muhammedozkan/CSE495-Graduation-Project-I---Flower-Watering-Bot/README.md

# CSE495-Graduation-Project-I-Flower-Watering-Bot

https://www.youtube.com/watch?v=L24rfd-ROjs
