muhammedozkan/CSE495-Graduation-Project-I---Flower-Watering-Bot/Lisans_Bitirme_Projesi_2_sunum.pdf

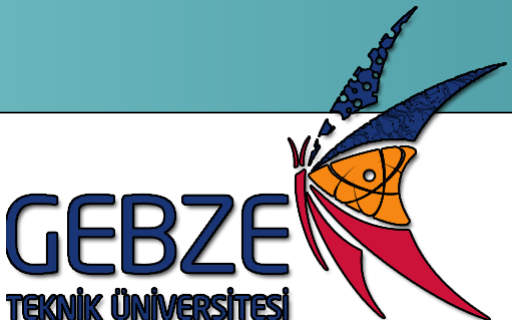
[picture p27: figure]

Bilgisayar Mühendisliği Bölümü

## CSE 495 2.Presentation

## Muhammed ÖZKAN

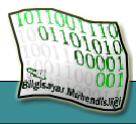
[picture p28: figure]

## Advisor: Dr. Alp Arslan BAYRAKÇI

## 2021 November

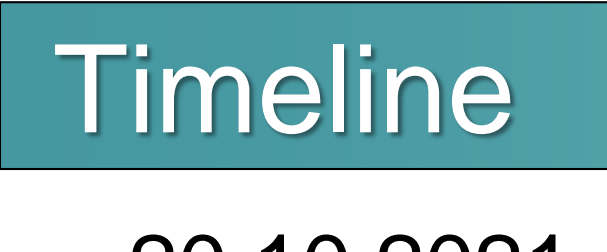
[picture p29: figure]
Timeline

GTÜ - Bilgisayar Mühendisliği Bölümü | BİL 495/496 Bitirme Projesi

# - 20.10.2021 - 10.11.2021 2.Presentation

Combining equipment.
Starting the hardware is the first tests. Performing the operation of finding a flower.

2

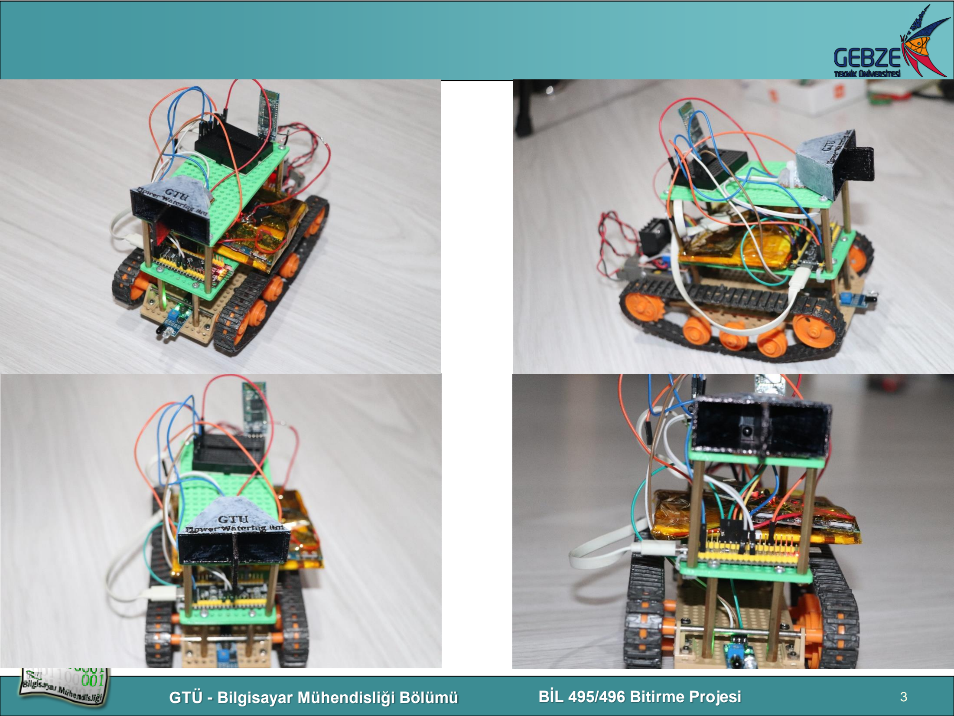
[picture p30: page 3]

GTÜ - Bilgisayar Mühendisliği Bölümü | BİL 495/496 Bitirme Projesi | 3

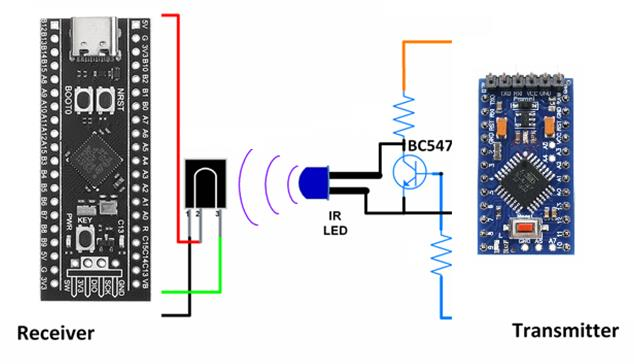
[picture p31: figure]

GTÜ - Bilgisayar Mühendisliği Bölümü | BİL 495/496 Bitirme Projesi | 4

# Scheme and Description of the Project

## - In this project, a

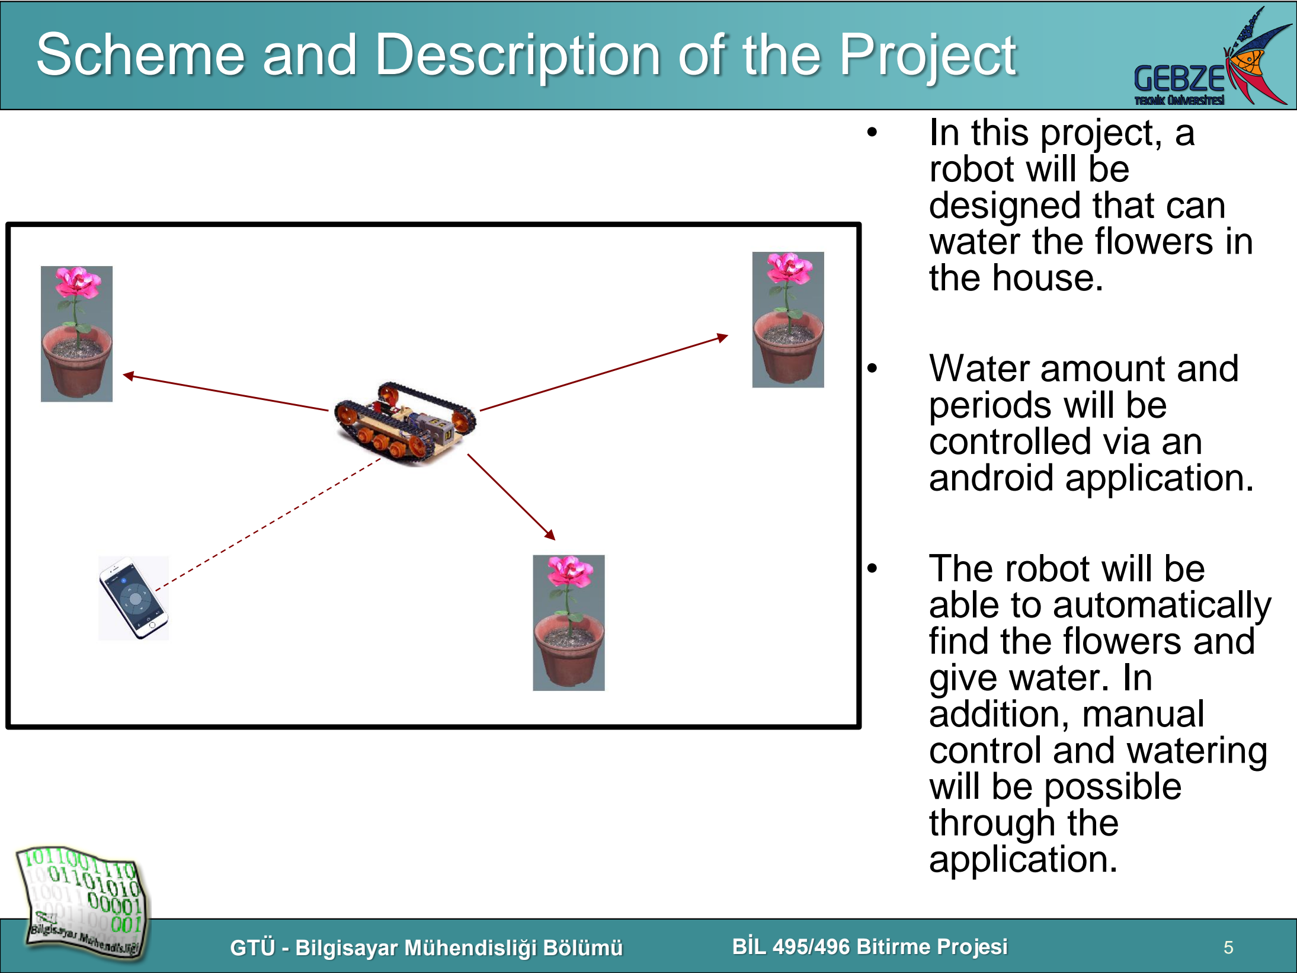
[picture p32: page 5]

GTÜ - Bilgisayar Mühendisliği Bölümü | BİL 495/496 Bitirme Projesi | 5

## robot will be designed that can water the flowers in

the house.

## - Water amount and periods will be controlled via an

android application.

## - The robot will be able to automatically find the flowers and give water. In addition, manual control and watering will be possible through the

application.

# Project Design Plan

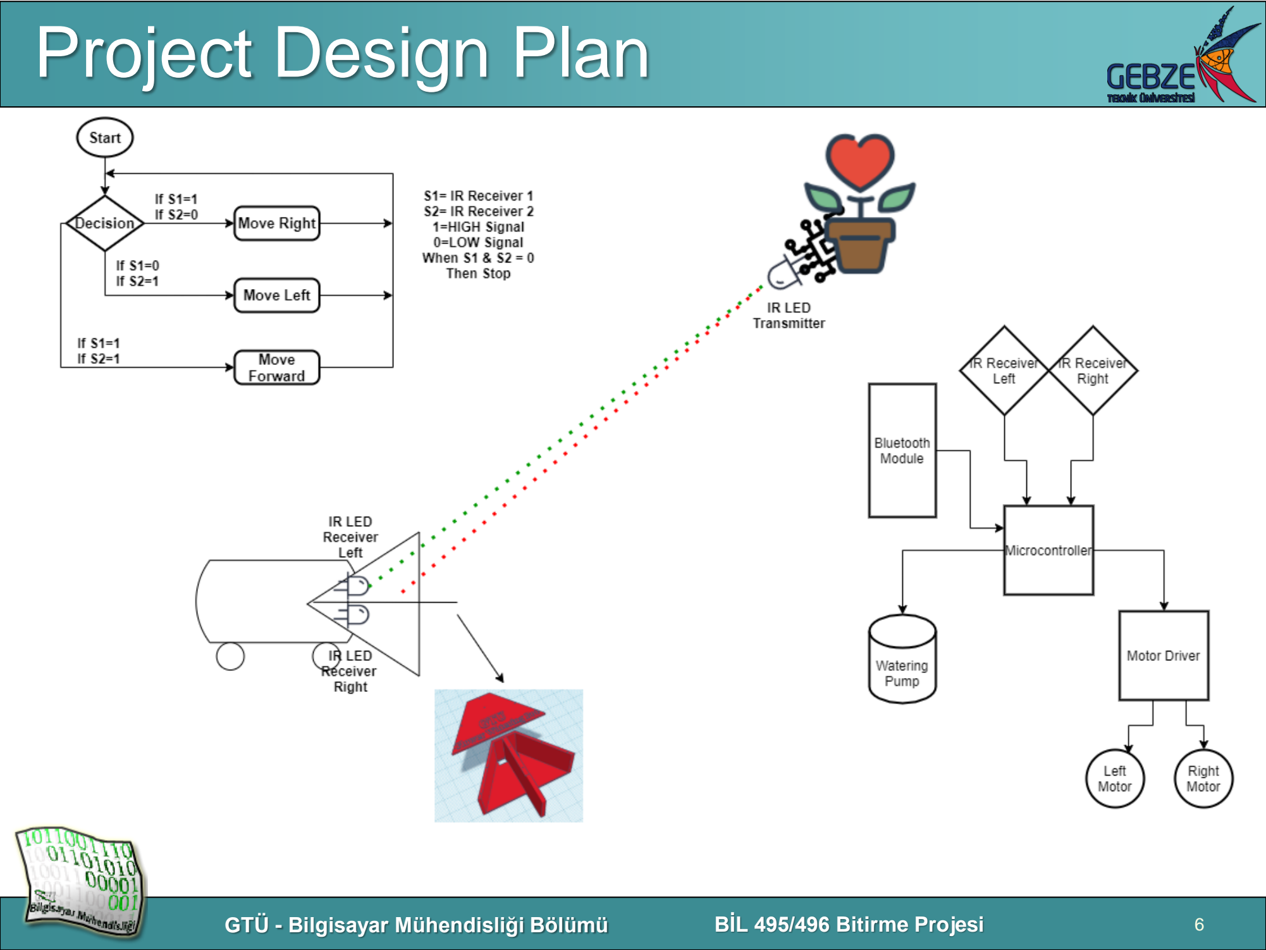
[picture p33: page 6]

GTÜ - Bilgisayar Mühendisliği Bölümü | BİL 495/496 Bitirme Projesi | 6

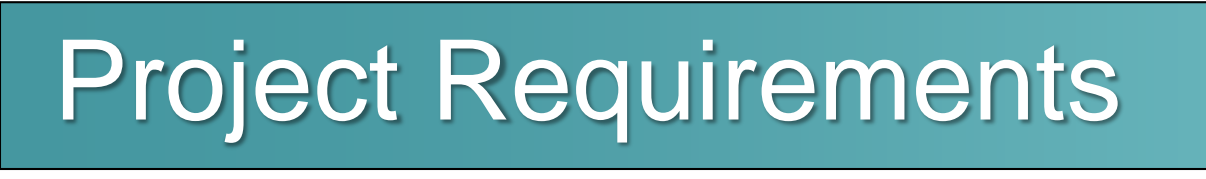
[picture p34: figure]
Project Requirements

GTÜ - Bilgisayar Mühendisliği Bölümü | BİL 495/496 Bitirme Projesi | 7
- All parts of the robot must be put together.

# - A system should be developed for flowers to send IR

signals.

# - An algorithm should be developed for the robot to move

forward with the incoming signals.

# - A system should be developed to find the desired flower by

means of IR signals with the robot.

# - An algorithm should be developed for Bluetooth

communication.
- Android application should be developed for robot control.
- A system should be designed for water pump control.

# Project Requirements

# Hardware Requirements

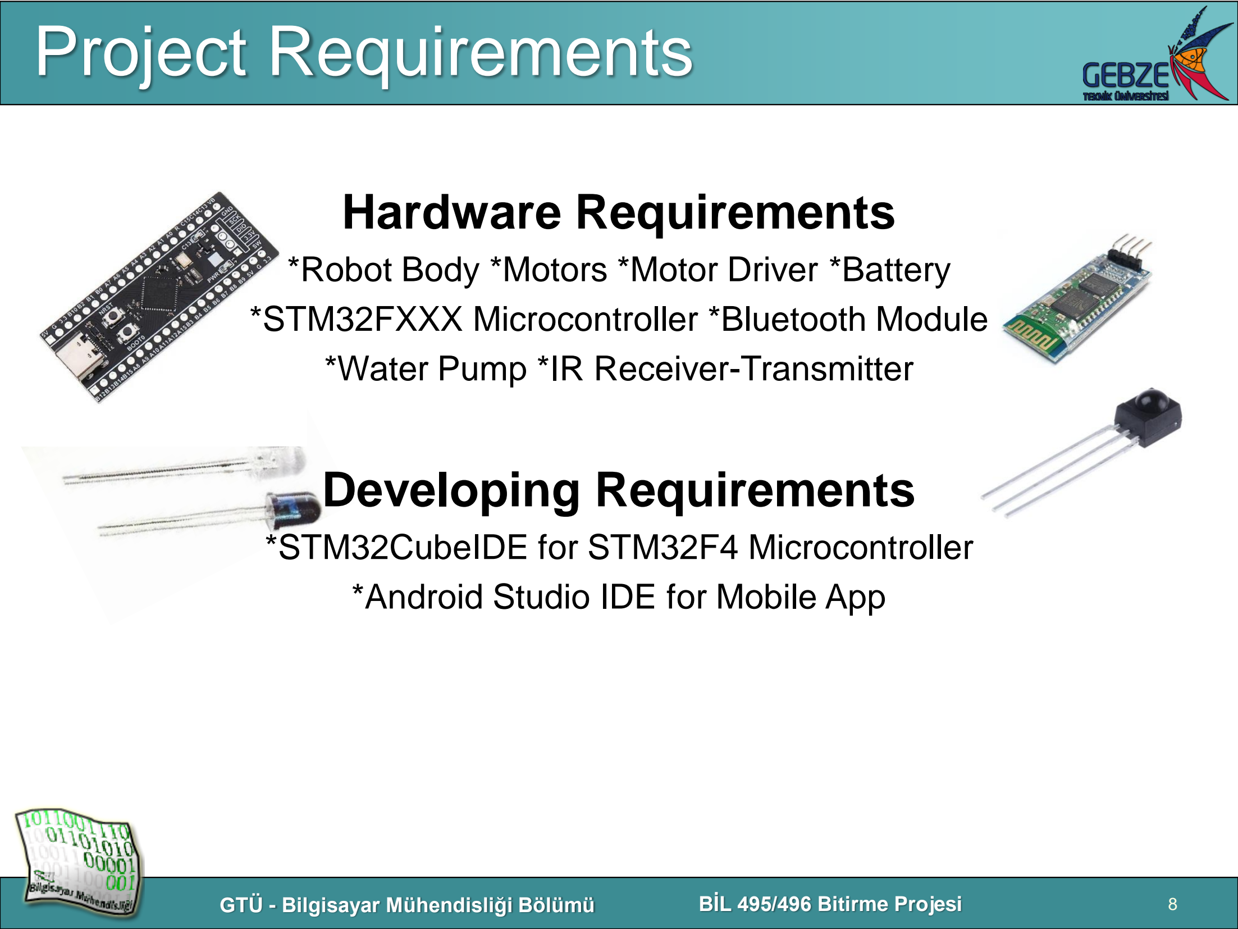
[picture p35: page 8]

GTÜ - Bilgisayar Mühendisliği Bölümü | BİL 495/496 Bitirme Projesi

## *Robot Body *Motors *Motor Driver *Battery *STM32FXXX Microcontroller *Bluetooth Module *Water Pump *IR Receiver-Transmitter

# Developing Requirements

## *STM32CubeIDE for STM32F4 Microcontroller *Android Studio IDE for Mobile App

8

GTÜ - Bilgisayar Mühendisliği Bölümü | BİL 495/496 Bitirme Projesi | 9

# 1. The flower to be watered must be found by the robot

in a 30m² environment.

# 2. The watering period and amount must be adjusted

via Bluetooth by application.

# 3. The flowers must be distinguishable by the device

and be watered differently period and amount.
4. It must be controlled manually via the application.

# (forward, backward, right, left) 5. The pump must be controlled manually via the

application.

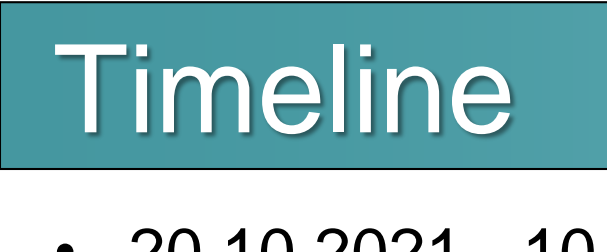
[picture p36: figure]
Timeline

GTÜ - Bilgisayar Mühendisliği Bölümü | BİL 495/496 Bitirme Projesi

# - 20.10.2021 - 10.11.2021 2.Presentation

Combining equipment.
Starting the hardware is the first tests. Performing the operation of finding a flower.

# - 10.11.2021 - 8.12.2021 3.Presentation

The presence of more than one flower separately.
The process of watering the flowers.
Design of mobile application, communication with hardware.

# - 8.12.2021 - 19.01.2022 4.Last Presentation

Control via mobile app.
Watering process via mobile. Watering amount and period setting.

10

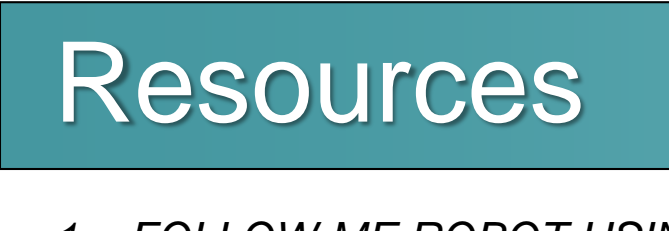
[picture p37: figure]
Resources

GTÜ - Bilgisayar Mühendisliği Bölümü | BİL 495/496 Bitirme Projesi | 11

## 1. FOLLOW ME ROBOT USING INFRARED BEACONS Salman Afghani, Muhammad Ishfaq Javed Army Public College of Management and Sciences, Rawalpindi, PAKISTAN ISSN-L: 2223-9553, ISSN: 2223-9944 Vol. 4 No. 3 May 2013
