muhammedozkan/CSE495-Graduation-Project-I---Flower-Watering-Bot/EmbededCode/WaterFlowerBot/Core/Src/main.c

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
/* Includes ------------------------------------------------------------------*/
#include "main.h"

/* USER CODE BEGIN Includes */
#include "mylib.h"
/* USER CODE END Includes */

TIM_HandleTypeDef htim2;

UART_HandleTypeDef huart1;
UART_HandleTypeDef huart2;
UART_HandleTypeDef huart6;

void SystemClock_Config(void);
static void MX_GPIO_Init(void);
static void MX_USART1_UART_Init(void);
static void MX_USART6_UART_Init(void);
static void MX_USART2_UART_Init(void);
static void MX_TIM2_Init(void);
/* USER CODE BEGIN 0 */
uint8_t Rx_left[10];
uint8_t Rx_right[10];

int8_t left = 0;
int8_t right = 0;

int8_t previous = 0;
uint8_t flowerCode = CODE_R;
uint8_t leftRightForward = 0;



uint16_t findAmount(uint8_t flowerCode)
{
	for (int8_t i = 0; i < 3; i++) {
			if (amount[i].flowerCode == flowerCode)
				return amount[i].waterAmount;
		}
return 0;
}

void stop() {
	HAL_GPIO_WritePin(GPIOA,
			RIGHT_BACKWARD_Pin | LEFT_FORWARD_Pin | LEFT_BACKWARD_Pin
					| RIGHT_FORWARD_Pin, GPIO_PIN_RESET);
	left = 0;
	right = 0;

}

void forward() {
	stop();
	HAL_GPIO_WritePin(GPIOA, RIGHT_FORWARD_Pin | LEFT_FORWARD_Pin,GPIO_PIN_SET);
	left = 1;
	right = 1;
}

void turnLeft() {
	stop();
	HAL_GPIO_WritePin(RIGHT_FORWARD_GPIO_Port, RIGHT_FORWARD_Pin, GPIO_PIN_SET);

	HAL_GPIO_WritePin(LEFT_BACKWARD_GPIO_Port, LEFT_BACKWARD_Pin, GPIO_PIN_SET);
	left = -1;
	right = 1;

	previous = -1;

}

void turnRight() {
	stop();
	HAL_GPIO_WritePin(LEFT_FORWARD_GPIO_Port, LEFT_FORWARD_Pin, GPIO_PIN_SET);

	HAL_GPIO_WritePin(RIGHT_BACKWARD_GPIO_Port, RIGHT_BACKWARD_Pin, GPIO_PIN_SET);
	left = 1;
	right = -1;

	previous = 1;

}
void backward() {
	stop();
	HAL_GPIO_WritePin(GPIOA, RIGHT_BACKWARD_Pin | LEFT_BACKWARD_Pin,GPIO_PIN_SET);
	left = -1;
	right = -1;

}

void readLeftSensor() {
	HAL_UART_Receive(&huart6, Rx_left, 10, 100);
}

void readRightSensor() {
	HAL_UART_Receive(&huart1, Rx_right, 10, 100);
}

void pumpON() {
	HAL_GPIO_WritePin(WATER_PUMP_GPIO_Port, WATER_PUMP_Pin, GPIO_PIN_RESET);
}

void pumpOFF() {
	HAL_GPIO_WritePin(WATER_PUMP_GPIO_Port, WATER_PUMP_Pin, GPIO_PIN_SET);
}

void pump(uint16_t time) {
	HAL_Delay(100);
	pumpON();
	HAL_Delay(time);
	pumpOFF();
	HAL_Delay(100);
}

void readSensor() {
	readLeftSensor();
	readRightSensor();
}

uint8_t karar(uint8_t code) {
	uint8_t rcount = 0;
	uint8_t lcount = 0;
	for (uint8_t i = 0; i < 10; ++i) // Using for loop we are initializing
			{
		if (Rx_right[i] == code) {
			rcount++;
		}

		if (Rx_left[i] == code) {
			lcount++;
		}

	}

	if (rcount > 0 && lcount > 0) {
		return 0;
	} else if (lcount > 0) {
		return 1;
	} else if (rcount > 0) {
		return 2;
	} else {
		return 3;
	}

}

void resetReadValue() {
	for (uint8_t i = 0; i < 10; ++i) {
		Rx_right[i] = Rx_left[i] = 0;
	}
}

uint8_t readProximity() {
	if (!HAL_GPIO_ReadPin(OBSTACLE_GPIO_Port, OBSTACLE_Pin)) {
		return 1;
	} else {
		return 0;
	}
}

void ara() {
	readSensor();
	leftRightForward = karar(flowerCode);

	switch (leftRightForward) {
	case 0:
		if (readProximity()) {
			HAL_Delay(100);
			stop();

			pump(findAmount(flowerCode));

			if (flowerCode == CODE_R)
				{flowerCode = CODE_G;}
			else if (flowerCode == CODE_G)
				{flowerCode = CODE_B;}
			else if (flowerCode == CODE_B)
				{flowerCode = CODE_R;
						backward();
						HAL_Delay(7500);
						stop();
						HAL_Delay(10000);}

		} else {
			forward();
		}
		break;

	case 1:

		turnLeft();
		break;

	case 2:

		turnRight();
		break;
	case 3:
		//obstacle detected
		if (readProximity()) {

			backward();
			HAL_Delay(5000);

		} else {
			if (previous > 0) {
				turnRight();

			} else {
				turnLeft();
			}

			//forward();
			//HAL_Delay(2500);
		}
		break;
	default:

		break;
	}

	resetReadValue();
}

/* USER CODE END 0 */

/**
  * @brief  The application entry point.
  * @retval int
  */
int main(void)
{
  /* MCU Configuration--------------------------------------------------------*/

  /* Reset of all peripherals, Initializes the Flash interface and the Systick. */
  HAL_Init();

  /* Configure the system clock */
  SystemClock_Config();

  /* Initialize all configured peripherals */
  MX_GPIO_Init();
  MX_USART1_UART_Init();
  MX_USART6_UART_Init();
  MX_USART2_UART_Init();
  MX_TIM2_Init();
  /* USER CODE BEGIN 2 */

	pumpOFF();
	HAL_Delay(100);
	memset(buffer, 0, sizeof(buffer));
	HAL_TIM_Base_Start_IT(&htim2);
	__HAL_UART_ENABLE_IT(&huart2, UART_IT_RXNE);

  /* USER CODE END 2 */

  /* Infinite loop */
  /* USER CODE BEGIN WHILE */
	while (1) {

		if (automode == 1) {
			ara();

		}

    /* USER CODE END WHILE */

    /* USER CODE BEGIN 3 */
	}
  /* USER CODE END 3 */
}

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
