muhammedozkan/CSE495-Graduation-Project-I---Flower-Watering-Bot/EmbededCode/WaterFlowerBot/Core/Inc/main.h

#define RIGHT_BACKWARD_Pin GPIO_PIN_4
#define RIGHT_BACKWARD_GPIO_Port GPIOA
#define LEFT_FORWARD_Pin GPIO_PIN_5
#define LEFT_FORWARD_GPIO_Port GPIOA
#define LEFT_BACKWARD_Pin GPIO_PIN_6
#define LEFT_BACKWARD_GPIO_Port GPIOA
#define RIGHT_FORWARD_Pin GPIO_PIN_7
#define RIGHT_FORWARD_GPIO_Port GPIOA
#define OBSTACLE_Pin GPIO_PIN_0
#define OBSTACLE_GPIO_Port GPIOB
#define WATER_PUMP_Pin GPIO_PIN_9
#define WATER_PUMP_GPIO_Port GPIOB
